Projet-Esme-2022-3B6/Chirurginoux/Liens utiles/Liens utiles.docx

# Liens utiles

Compréhension axes / coordonnées Kinect :

https://lisajamhoury.medium.com/understanding-kinect-v2-joints-and-coordinate-system-4f4b90b9df16
