Projet-Esme-2022-3B6/Chirurginoux/Docs/Modele-Geometrique (1).docx

Z3

X3

Y3

d_4 =375

α_2 =253

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
Axe | θ | d | a | α
1 | θ_1 | d_1 =145 | 0 | -π/2
2 | θ_2 | 0 | a_2 =253 | 0
3 | θ_3 =θ^(') _3 -π/2 | 0 | a_3 =375 | 0
4 | θ_4 | d_4 =375 | 0 | -π/2

d_1 =145

Y0

Z0

X0

T_0^1 =C_1 , 0, -S_1 , 0S_1 , 0, C_1 , 00, -1, 0, d_1 0, 0, 0, 1 T_1^2 =C_2 , -S_2 , 0, a_2 C_2 S_2 , C_2 , 0, a_2 S_2 0, 0, 1, 00, 0, 0, 1

T_0^2 =C_1 C_2 , -C_1 S_2 , -S_1 , a_2 C_1 C_2 S_1 C_2 , -S_1 S_2 , C_1 , a_2 S_1 C_2 -S_2 , -C_2 , 0, d_1 -a_2 S_2 0, 0, 0, 1 T_2^3 =C_3 , -S_3 , 0, a_3 C_3 S_3 , C_3 , 0, a_3 S_3 0, 0, 1, 00, 0, 0, 1

T_0^3 =C_1 C_2 C_3 -C_1 S_2 S_3 , -C_1 C_2 S_3 -C_1 S_2 C_3 , -S_1 , C_1 C_2 a_3 C_3 -C_1 S_2 a_3 S_3 +a_2 C_1 C_2 S_1 C_2 C_3 -S_1 S_2 S_3 , -S_1 C_2 S_3 -S_1 S_2 C_3 , C_1 , S_1 C_2 a_3 C_3 -S_1 S_2 a_3 S_3 +a_2 S_1 C_2 -S_2 C_3 -C_2 S_3 , S_2 S_3 -C_2 C_3 , 0, d_1 -a_2 S_2 0, 0, 0, 1

T_0^3 =C_1 C_23 , -C_1 S_23 , -S_1 , C_1 (a_3 C_23 +a_2 C_2 )S_1 C_23 , -S_1 S_23 , C_1 , S_1 (a_3 C_23 +a_2 C_2 )-S_23 , -C_23 , 0, d_1 -a_2 S_2 0, 0, 0, 1 T_3^4 =1, 0, 0, 00, 0, 1, 00, -1, 0, 00, 0, 0, 1

T_0^4 =C_1 C_23 , S_1 , -C_1 S_23 , C_1 (a_3 C_23 +a_2 C_2 )S_1 C_23 , -C_1 , -S_1 S_23 , S_1 (a_3 C_23 +a_2 C_2 )-S_23 , 0, -C_23 , d_1 -a_2 S_2 0, 0, 0, 1
T_4^5 =C_5 , -S_5 , 0, 0S_5 , C_5 , 0, 00, 0, 1, 00, 0, 0, 1

T_0^5 =C_4 C_1 C_23 +S_4 S_1 , -S_4 C_1 C_23 +C_4 S_1 , -C_1 S_23 , C_1 (a_3 C_23 +a_2 C_2 )C_4 S_1 C_23 -S_4 C_1 , -S_4 S_1 C_23 -C_4 C_1 , -S_1 S_23 , S_1 (a_3 C_23 +a_2 C_2 )-C_4 S_23 , S_4 S_23 , -C_23 , d_1 -a_2 S_2 0, 0, 0, 1

w(q)=[C_1 (a_2 C_2 -d_4 S_23 )S_1 (a_2 C_2 -d_4 S_23 )d_1 -a_2 S_2 -d_4 C_23 ⋯⋯⋯⋯⋯⋯⋯⋯-e^((q_4)/π) C_1 S_23 -e^((q_4)/π) S_1 S_23 -e^((q_4)/π) C_23 ]

(w_2)/(w_1)=(S_1 (a_2 C_2 -d_4 S_23 ))/(C_1 (a_2 C_2 -d_4 S_23 ))=(S_1)/(C_1)→q_1 =atan2(w_2 ,w_1 )

C_1 w_4 +S_1 w_5 =-e^((q_4)/π) C_1^2 S_23 -e^((q_4)/π) S_1^2 S_23 =-e^((q_4)/π) S_23 (C_1^2 +S_1^2 )=-e^((q_4)/π) S_23

(C_1 w_4 +S_1 w_5)/(w_6)=(-e^((q_4)/π) S_23)/(-e^((q_4)/π) C_23)=(S_23)/(C_23)→q_23 =atan2((C_1 w_4 +S_1 w_5 ) , w_6 )

C_1 w_1 +S_1 w_2 =C_1^2 (a_2 C_2 -d_4 S_23 )+S_1^2 (a_2 C_2 -d_4 S_23 )=a_2 C_2 -d_4 S_23

→C_2 =(C_1 w_1 +S_1 w_2 +d_4 S_23)/(a_2)

d_1 -w_3 =a_2 S_2 +d_4 C_23 (d_1 -w_3 -d_4 C_23)/(C_1 w_1 +S_1 w_2 +d_4 S_23)=(S_2)/(C_2)

→S_2 =(d_1 -w_3 -d_4 C_23)/(a_2) →q_2 =atan2(d_1 -w_3 -d_4 C_23 , C_1 w_1 +S_1 w_2 +d_4 S_23 )

w_4^2 +w_5^2 +w_6^2 =(-e^((q_4)/π) C_1 S_23 )^2 +(-e^((q_4)/π) S_1 S_23 )^2 +(-e^((q_4)/π) C_23 )^2 =(e^((q_4)/π) )^2 (S_23 ^2 (C_1 ^2 +S_1 ^2 )+C_23 ^2 )

q_4 =π ln(√(w_4^2 +w_5^2 +w_6^2))

q_1 =atan2(w_2 ,w_1 )

q_23 =atan2((C_1 w_4 +S_1 w_5 ) , w_6 )

q_2 =atan2(d_1 -w_3 -d_4 C_23 , C_1 w_1 +S_1 w_2 +d_4 S_23 )

q_3 =q_23 -q_2

q_4 =π ln(√(w_4^2 +w_5^2 +w_6^2))
