Projet-Esme-2022-3B6/Chirurginoux/Docs/Modèle géométrique.docx

X3

Y3

Z3

Z4

X4

d_5 =375

a_3 =253

X5

Z2

X2

Y2

Y5

Z5

Y4

d_2 =145

Axe | θ | d | a | α | Home
1 | θ_1 | 0 | 0 | 0 | 0
2 | θ_2 | d_2 =145 | 0 | -π/2 | 0
3 | θ_3 | 0 | a_3 =253 | 0 | 0
4 | θ_4 =θ^(') _4 -π/2 | 0 | 0 | -π/2 | -π/2
5 | 0 | d_5 =375 | 0 | 0

Z0 = Z1

Y0

X0

T_(K-1)^K =[Cθ_k , -Cα_k Sθ_k , Sα_k Sθ_k , ⋮, a_k Cθ_k Sθ_k , Cα_k Cθ_k , -Sα_k Cθ_k , ⋮, a_k Sθ_k 0, Sα_k , Cα_k , ⋮, d_k ⋯, ⋯, ⋯, ⋮, ⋯0, 0, 0, ⋮, 1]

T_1^2 =C_2 , 0, -S_2 , 0S_2 , 0, C_2 , 00, -1, 0, d_2 0, 0, 0, 1

T_0^1 =C_1 , -S_1 , 0, 0S_1 , C_1 , 0, 00, 0, 1, 00, 0, 0, 1 T_0^2 =C_1 C_2 -S_1 S_2 , 0, -C_1 S_2 -S_1 C_2 , 0S_1 C_2 +C_1 S_2 , 0, -S_1 S_2 +C_1 C_2 , 00, -1, 0, d_2 0, 0, 0, 1

T_2^3 =C_3 , -S_3 , 0, a_3 C_3 S_3 , C_3 , 0, a_3 S_3 0, 0, 1, 00, 0, 0, 1

T_0^2 =C_(1,2) , 0, -S_(1,2) , 0S_(1,2) , 0, C_(1,2) , 00, -1, 0, d_2 0, 0, 0, 1 T_0^3 =C_(1,2) C_3 , -C_(1,2) S_3 , -S_(1,2) , C_(1,2) a_3 C_3 S_(1,2) C_3 , -S_(1,2) S_3 , C_(1,2) , S_(1,2) a_3 C_3 -S_3 , -C_3 , 0, -a_3 S_3 +d_2 0, 0, 0, 1

T_3^4 =C_4 , 0, -S_4 , 0S_4 , 0, C_4 , 00, -1, 0, 00, 0, 0, 1

T_0^3 =C_(1,2) C_3 , -C_(1,2) S_3 , -S_(1,2) , C_(1,2) a_3 C_3 S_(1,2) C_3 , -S_(1,2) S_3 , C_(1,2) , S_(1,2) a_3 C_3 -S_3 , -C_3 , 0, -a_3 S_3 +d_2 0, 0, 0, 1

T_0^4 =C_(1,2) (C_3 C_4 -S_3 S_4 ), S_(1,2) , -C_(1,2) (C_3 S_4 +S_3 C_4 ), C_(1,2) a_3 C_3 S_(1,2) (C_3 C_4 -S_3 S_4 ), -C_(1,2) , -S_(1,2) (C_3 S_4 +S_3 C_4 ), S_(1,2) a_3 C_3 -S_3 C_4 -C_3 S_4 , 0, S_3 S_4 -C_3 C_4 , -a_3 S_3 +d_2 0, 0, 0, 1

T_4^5 =1, 0, 0, 00, 1, 0, 00, 0, 1, d_5 0, 0, 0, 1

T_0^4 =C_(1,2) C_(3,4) , S_(1,2) , -C_(1,2) S_(3,4) , a_3 C_(1,2) C_3 S_(1,2) C_(3,4) , -C_(1,2) , -S_(1,2) S_(3,4) , a_3 S_(1,2) C_3 -S_(3,4) , 0, -C_(3,4) , -a_3 S_3 +d_2 0, 0, 0, 1

T_0^5 =C_(1,2) C_(3,4) , S_(1,2) , -C_(1,2) S_(3,4) , C_(1,2) (a_3 C_3 -S_(3,4) d_5 )S_(1,2) C_(3,4) , -C_(1,2) , -S_(1,2) S_(3,4) , S_(1,2) (a_3 C_3 -S_(3,4) d_5 )-S_(3,4) , 0, -C_(3,4) , d_2 -a_3 S_3 -C_(3,4) d_5 0, 0, 0, 1

w(q)=[C_(1,2) (a_3 C_3 -S_(3,4) d_5 )S_(1,2) (a_3 C_3 -S_(3,4) d_5 )d_2 -a_3 S_3 -C_(3,4) d_5 ⋯⋯⋯⋯⋯⋯⋯⋯-e^((q_4)/π) C_(1,2) S_(3,4) -e^((q_4)/π) S_(1,2) S_(3,4) -e^((q_4)/π) C_(3,4) ]

(w_2)/(w_1)=(S_(1,2) (a_3 C_3 -S_(3,4) d_5 ))/(C_(1,2) (a_3 C_3 -S_(3,4) d_5 ))=(S_(1,2))/(C_(1,2))→q_(1,2) =atan2(w_2 ,w_1 )

C_(1,2) w_4 +S_(1,2) w_5 =-e^((q_4)/π) C_(1,2)^2 S_(3,4) -e^((q_4)/π) S_(1,2)^2 S_(3,4) =-e^((q_4)/π) S_(3,4) (C_(1,2)^2 +S_(1,2)^2 )=-e^((q_4)/π) S_(3,4)

(C_(1,2) w_4 +S_(1,2) w_5)/(w_6)=(-e^((q_4)/π) S_(3,4))/(-e^((q_4)/π) C_(3,4))=(S_(3,4))/(C_(3,4))→q_(3,4) =atan2((C_(1,2) w_4 +S_(1,2) w_5 ) , w_6 )

√(w_4^2 +w_5^2 +w_6^2)=e^((q_4)/π) √((S_(3,4) ^2 (C_(1,2) ^2 +S_(1,2) ^2 )+C_(3,4) ^2 ))=e^((q_4)/π)

q_4 =π ln(√(w_4^2 +w_5^2 +w_6^2))

q_(1,2) =atan2(w_2 ,w_1 )

q_(3,4) =atan2((C_(1,2) w_4 +S_(1,2) w_5 ) , w_6 )

q_4 =π ln(√(w_4^2 +w_5^2 +w_6^2))

q_3 =q_(3,4) -q_4
