Projet-Esme-2022-3B6/Chirurginoux/Docs/Commande Projet Groupe 6 .xlsx

Composants |  | Liens | Nombres | Prix | Description
Moteurs 35KG |  | https://www.amazon.fr/FEICHAO-num%C3%A9rique-%C3%A9tanche-Aluminium-Engrenages/dp/B08CSCLGHV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 | 2 | 59.96 | Moteurs pour les 2 bras
Convertisseurs DC/DC |  | https://www.amazon.fr/6paquets-Converter-3-0-40V-1-5-35V-Convertisseur/dp/B07793ZH9K?hvadid=313717846711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 | 1 paquet | 10.69 | Dispo à l'ecole
Cables Males / femelles |  | https://www.amazon.fr/Elegoo-Breadboard-Femelle-Longueur-Arduino/dp/B01JD5WCG2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 | 1 paquet | 9.99 | Dispo à l'ecole
Roulement à billes |  | https://www.amazon.fr/roulements-multi-usages-caoutchouc-profonde-6001-2RS/dp/B07N82SK41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 | 1 paquet | 19.69 | Dispo à l'ecole
Moteurs MG996R |  | https://www.amazon.fr/Diymore-Digital-H%C3%A9licopt%C3%A8re-Voiture-commandes/dp/B07KD6NVPM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 | 2 | 17.99 | Dispo à l'ecole / Moteurs pour base et pince
Câbles Ralonge Moteur |  | https://www.amazon.fr/GTIWUNG-Extension-Dextension-Servomoteur-Recepteur/dp/B082WYFWSY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 | 1 paquet | 12.99 | Cable de rallonge esthetique
scalpel |  | https://www.amazon.fr/Westcott-84010-00-Scalpel-poign%C3%A9e-interchangeable-argent/dp/B002QRKARS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 | 1 | 4.42
adaptateur ethernet / usb |  | https://www.amazon.fr/Mobi-Lock-Adaptateur-P%C3%A9riph%C3%A9riques-Compatibles/dp/B00NLL10P4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 | 1 | 9.99
Plaque wrapping |  | https://www.amazon.fr/Prototype-Circuit-Universel-Prototypage-Bbricolage/dp/B08YXKRJY1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 | 1 paquet | 8.99 | Dispo à l'ecole
Transformateur 220V 12V |  | https://www.amazon.fr/Transformateur-Adaptateur-Bande-Alimentation-V-220/dp/B01G0Q3RWU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 | 1 | 8.42
Microsoft Kinect V2 |  |  |  | 80 | Deja Reçu
Raspberry Pi 3B+ |  |  |  | 61 | Deja Reçu
Prix Total | 304.13 | / 150
