Projet-Esme-2022-3B6/Chirurginoux/3D/3D 2.0/Motor/Servo MG996R/MG996R.SLDASM

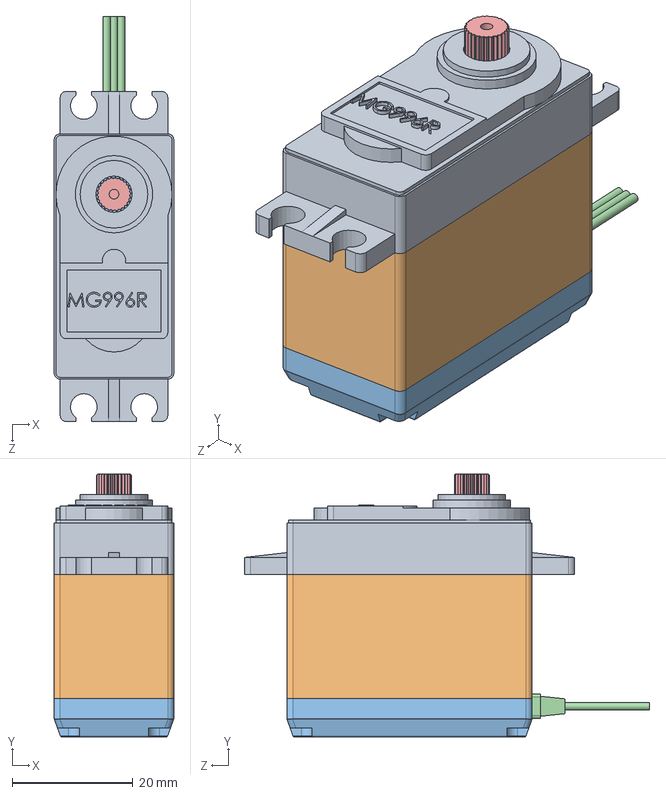
[picture p15: CAD file, 2022-01-17]
3D/3D 2.0/Motor/Servo MG996R/MG996R.SLDASM
19.8 x 43.5 x 67.0 mm
Top MG996R
Middle MG996R
Bottom MG996R
Connector MG996R
Shaft MG996R
