Projet-Esme-2022-3B6/Chirurginoux/3D/3D/Motor/Servo 35KG/Servo 35kg.SLDASM

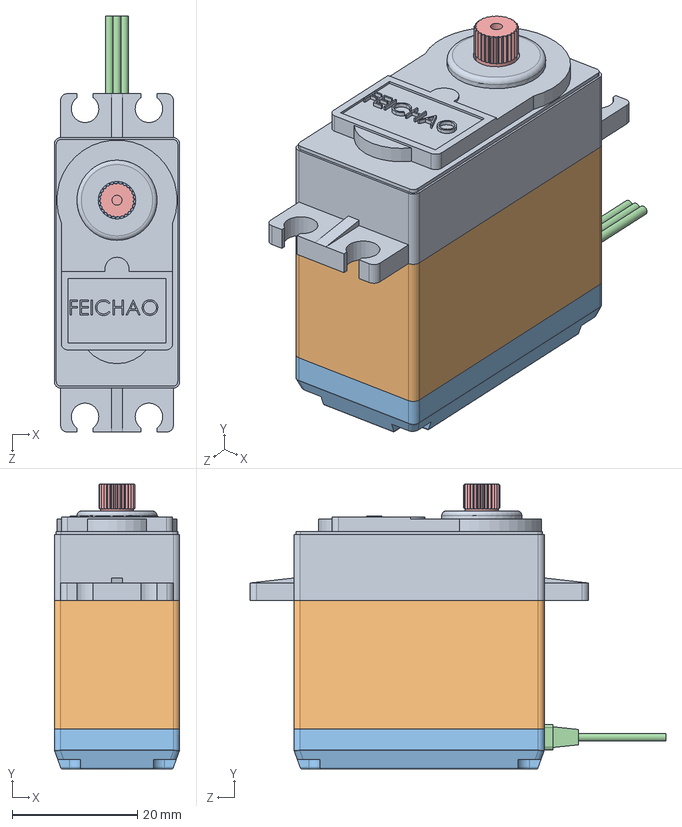
[picture p16: CAD file, 2022-01-17]
3D/3D/Motor/Servo 35KG/Servo 35kg.SLDASM
20.0 x 45.5 x 66.4 mm
BODY, TOP
BODY, MIDDLE
BOTTOM
CONNECTOR
SHAFT
