Projet-Esme-2022-3B6/Chirurginoux/3D/Ancienne Version/3D V3/Roulement à billes/Assemblage Roulement.SLDASM

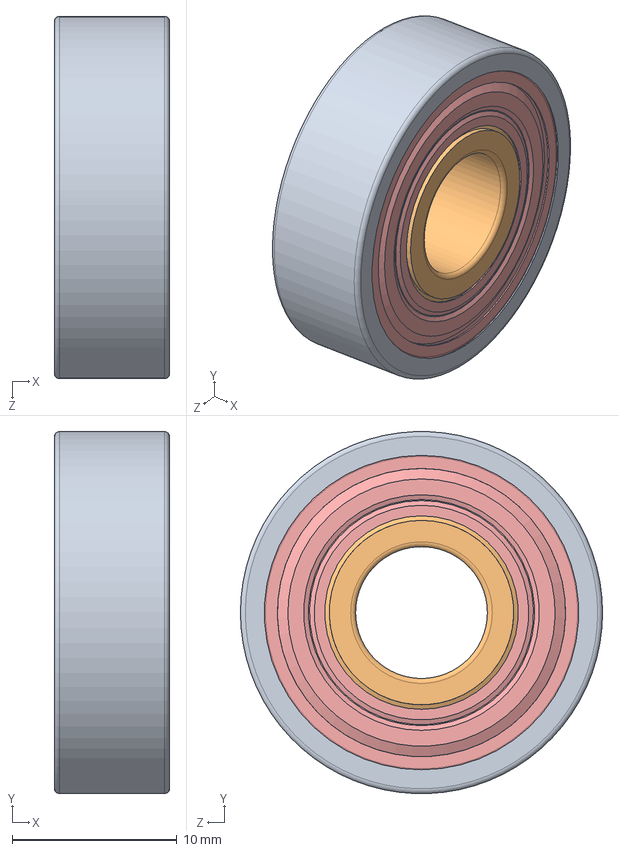
[picture p17: CAD file, 2022-01-17]
3D/Ancienne Version/3D V3/Roulement à billes/Assemblage Roulement.SLDASM
7.00 x 22.0 x 22.0 mm
Roulement 1
Roulement 2
Roulement 3
Roulement 4
Roulement 5
