Projet-Esme-2022-3B6/Chirurginoux/3D/3D 2.0/Assemblage Kinect Arm 2.0.SLDASM

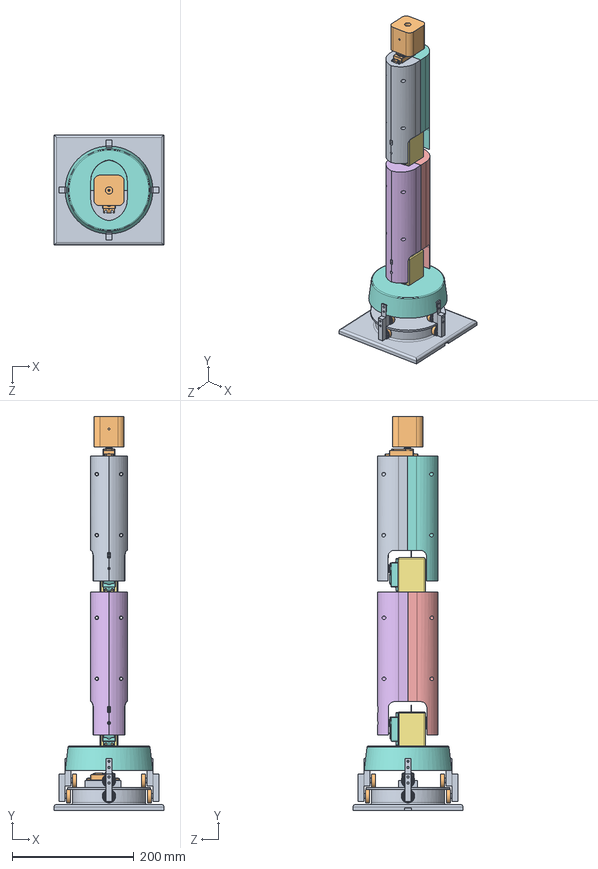
[picture p18: CAD file, 2022-03-29]
3D/3D 2.0/Assemblage Kinect Arm 2.0.SLDASM
180.0 x 646.0 x 180.0 mm
base
Top MG996R x 2
Middle MG996R x 2
Bottom MG996R x 2
Connector MG996R x 2
Shaft MG996R x 2
Servo Control Horns MG996R
tronc
Pate Tronc x 8
Roulement 1 x 10
Roulement 2 x 10
Roulement 3 x 10
Roulement 4 x 10
Roulement 5 x 10
Support Moteur 2.0 x 2
BODY, TOP x 2
BODY, MIDDLE x 2
BOTTOM x 2
CONNECTOR x 2
SHAFT x 2
Bras séparé Roulement
Bras séparé Motor
25T Horns x 2
Avant Bras séparé Roulement
Avant Bras séparé Motor
Pièce_support_scalpel
