Projet-Esme-2022-3B6/Chirurginoux/3D/3D 2.0/Scalpel/Scalpel FEATHER #3.SLDASM

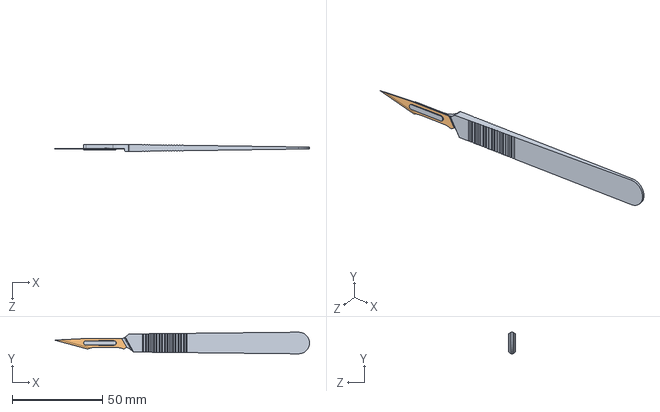
[picture p20: CAD file, 2022-03-29]
3D/3D 2.0/Scalpel/Scalpel FEATHER #3.SLDASM
141.1 x 12.0 x 4.00 mm
Scalpel FEATHER #3 - Manche
Scalpel FEATHER #3 - Lame
