Projet-Esme-2022-3B6/Chirurginoux/3D/Ancienne Version/3D V3/Assemblage Base-Tronc.SLDASM

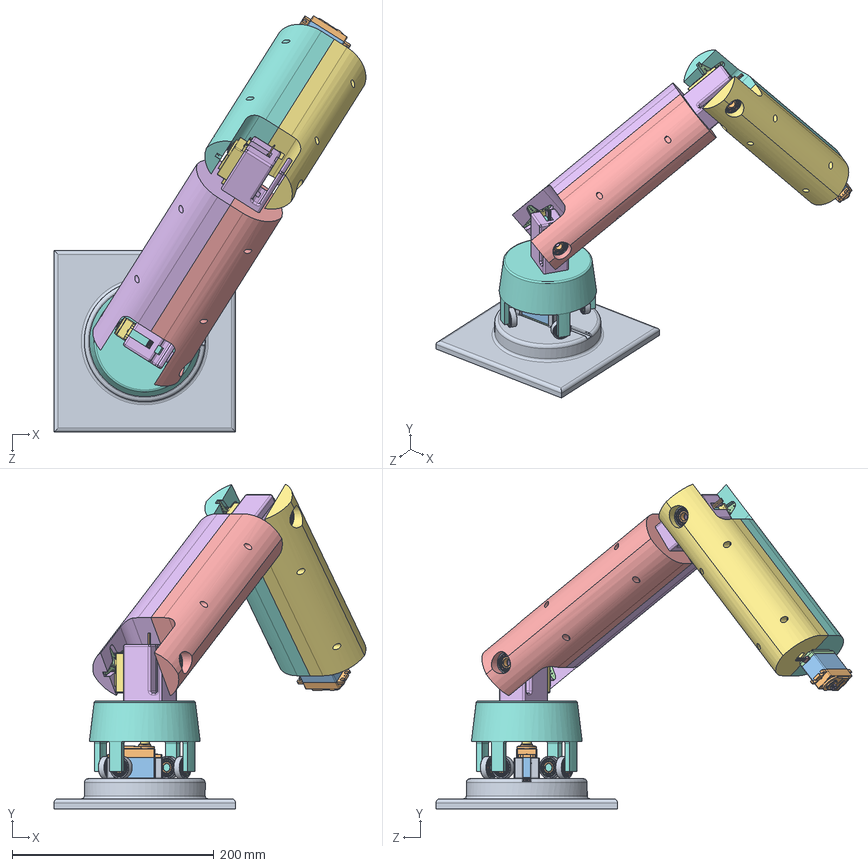
[picture p21: CAD file, 2022-01-17]
3D/Ancienne Version/3D V3/Assemblage Base-Tronc.SLDASM
309.3 x 322.0 x 412.5 mm
base
Top MG996R x 2
Middle MG996R x 2
Bottom MG996R x 2
Connector MG996R x 2
Shaft MG996R x 2
Servo Control Horns MG996R
tronc
Roulement 1 x 6
Roulement 2 x 6
Roulement 3 x 6
Roulement 4 x 6
Roulement 5 x 6
Support Moteur 2.0 x 2
BODY, TOP x 2
BODY, MIDDLE x 2
BOTTOM x 2
CONNECTOR x 2
SHAFT x 2
Servo Control Horns x 2
Bras séparé en deux1
Bras séparé en deux2
Avant Bras séparé en deux1
Avant Bras séparé en deux2
