Projet-Esme-2022-3B6/Chirurginoux/3D/3D 2.0/Bras/Bras séparé Motor.SLDPRT

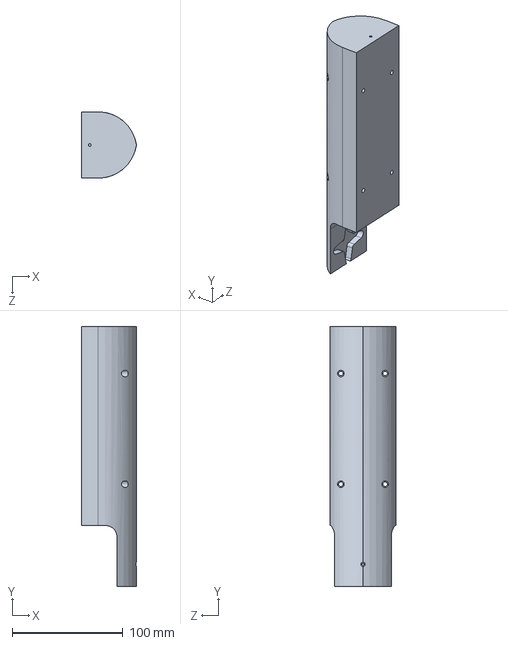
[picture p23: CAD file, 2022-01-20]
3D/3D 2.0/Bras/Bras séparé Motor.SLDPRT
49.6 x 235.0 x 60.0 mm
