Projet-Esme-2022-3B6/Chirurginoux/3D/3D 2.0/Motor/Servo 35KG/25T Horns.SLDPRT

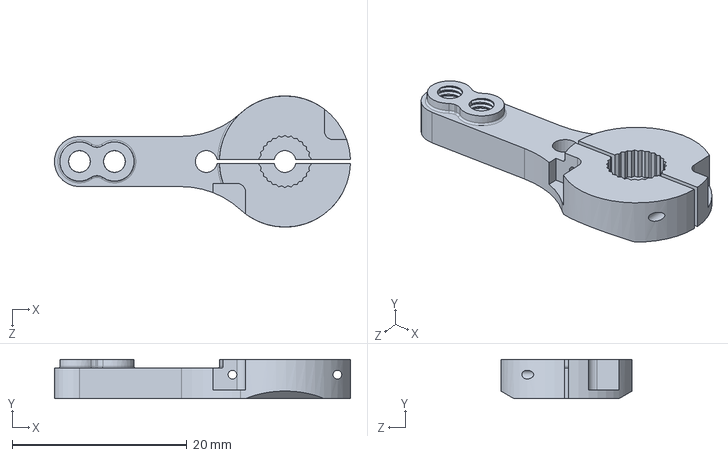
[picture p24: CAD file, 2022-01-20]
3D/3D 2.0/Motor/Servo 35KG/25T Horns.SLDPRT
33.8 x 4.50 x 15.0 mm
