Projet-Esme-2022-3B6/Chirurginoux/3D/3D 2.0/Pièce_support_scalpel.SLDPRT

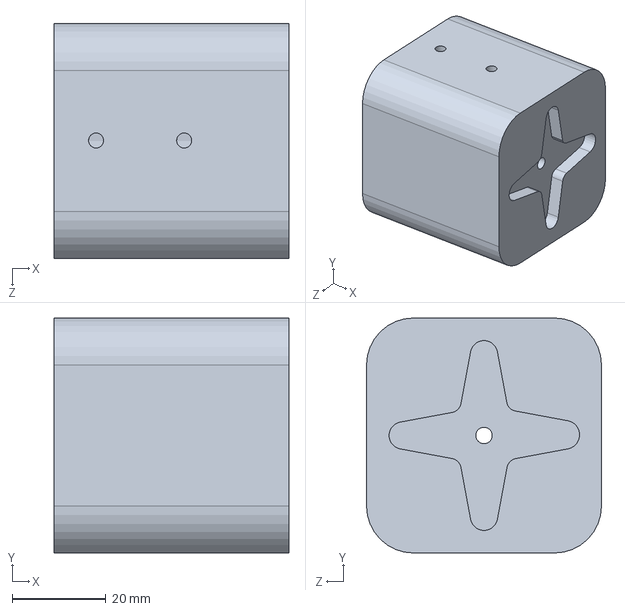
[picture p25: CAD file, 2022-03-29]
3D/3D 2.0/Pièce_support_scalpel.SLDPRT
50.0 x 50.0 x 50.0 mm
