Projet-Esme-2022-3B6/Chirurginoux/3D/3D 2.0/Scalpel/Scalpel FEATHER #3 - Lame.SLDPRT

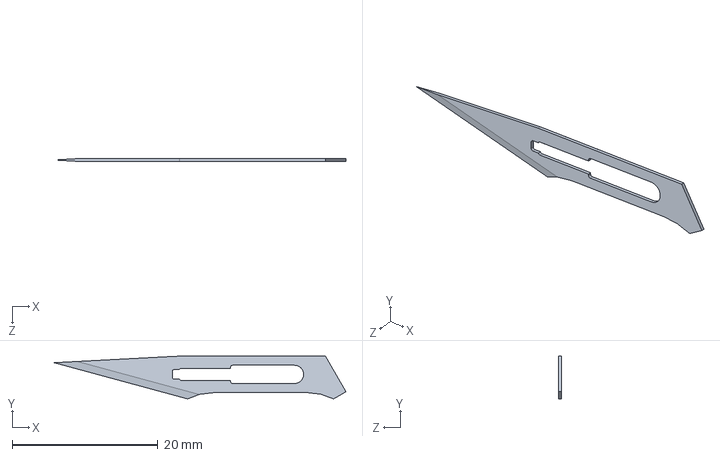
[picture p26: CAD file, 2022-03-29]
3D/3D 2.0/Scalpel/Scalpel FEATHER #3 - Lame.SLDPRT
40.0 x 5.86 x 0.38 mm
