Projet-Esme-2022-3B6/Chirurginoux/3D/3D/Bras/Bras séparé en deux1 .SLDPRT

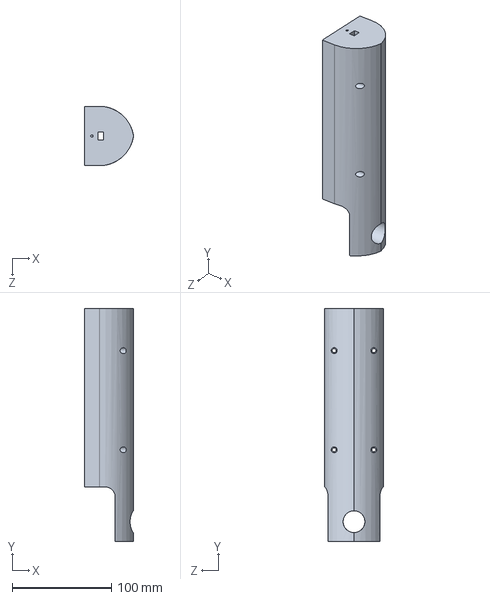
[picture p27: CAD file, 2022-01-17]
3D/3D/Bras/Bras séparé en deux1 .SLDPRT
49.6 x 235.0 x 60.0 mm
