Projet-Esme-2022-3B6/Chirurginoux/3D/3D/Motor/Servo MG996R/Connector MG996R.SLDPRT

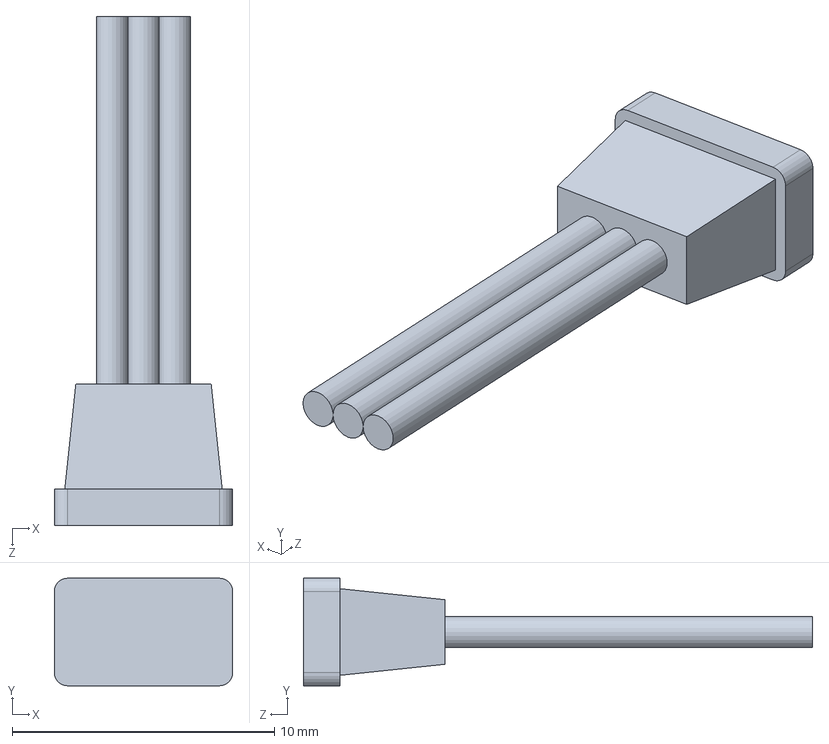
[picture p28: CAD file, 2022-01-17]
3D/3D/Motor/Servo MG996R/Connector MG996R.SLDPRT
6.80 x 4.10 x 19.4 mm
