Projet-Esme-2022-3B6/Chirurginoux/3D/3D/Support Moteur 2.0.SLDPRT

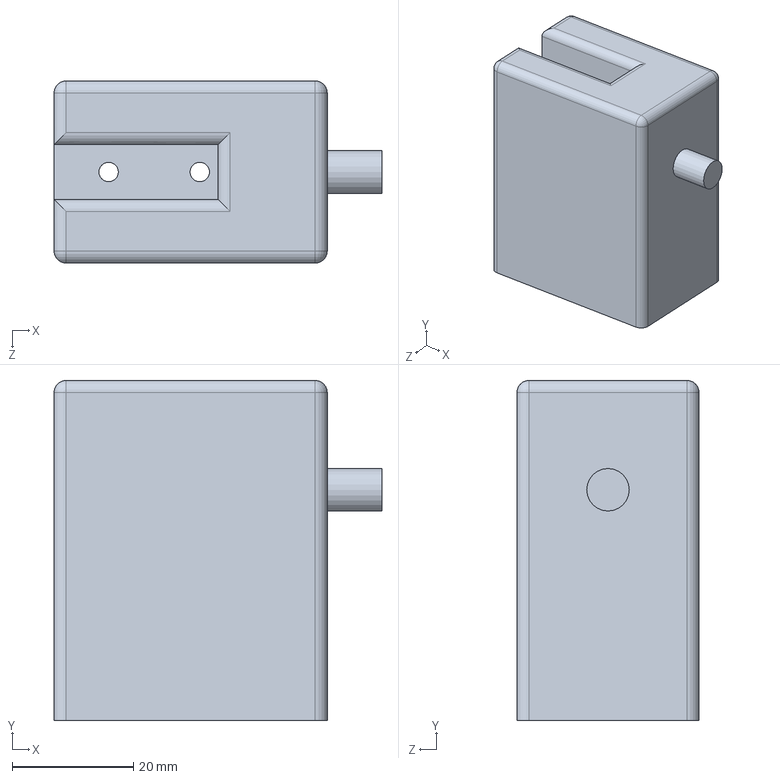
[picture p29: CAD file, 2022-01-17]
3D/3D/Support Moteur 2.0.SLDPRT
54.0 x 56.0 x 30.0 mm
