Projet-Esme-2022-3B6/Chirurginoux/3D/Ancienne Version/3D V3/Motor/Servo 35KG/HORN.SLDPRT

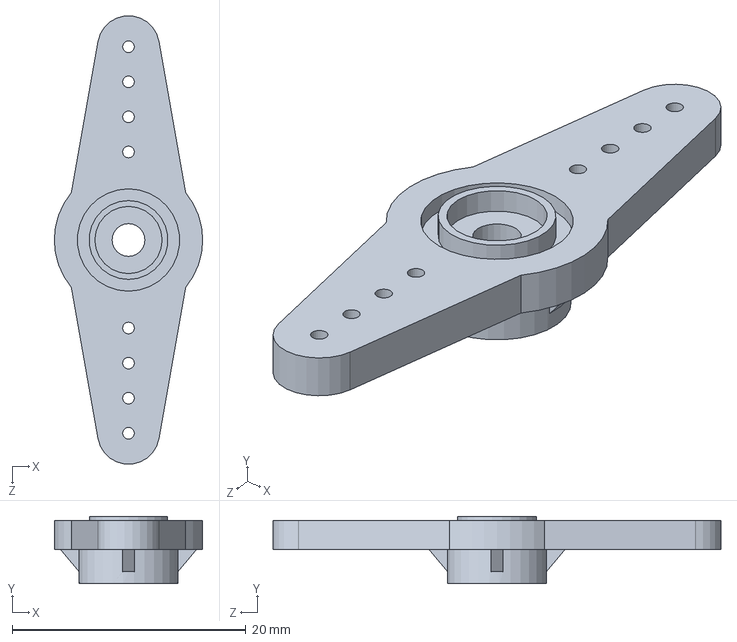
[picture p30: CAD file, 2022-01-17]
3D/Ancienne Version/3D V3/Motor/Servo 35KG/HORN.SLDPRT
12.7 x 5.75 x 38.3 mm
