Projet-Esme-2022-3B6/Chirurginoux/3D/Ancienne Version/3D V3/tronc.SLDPRT

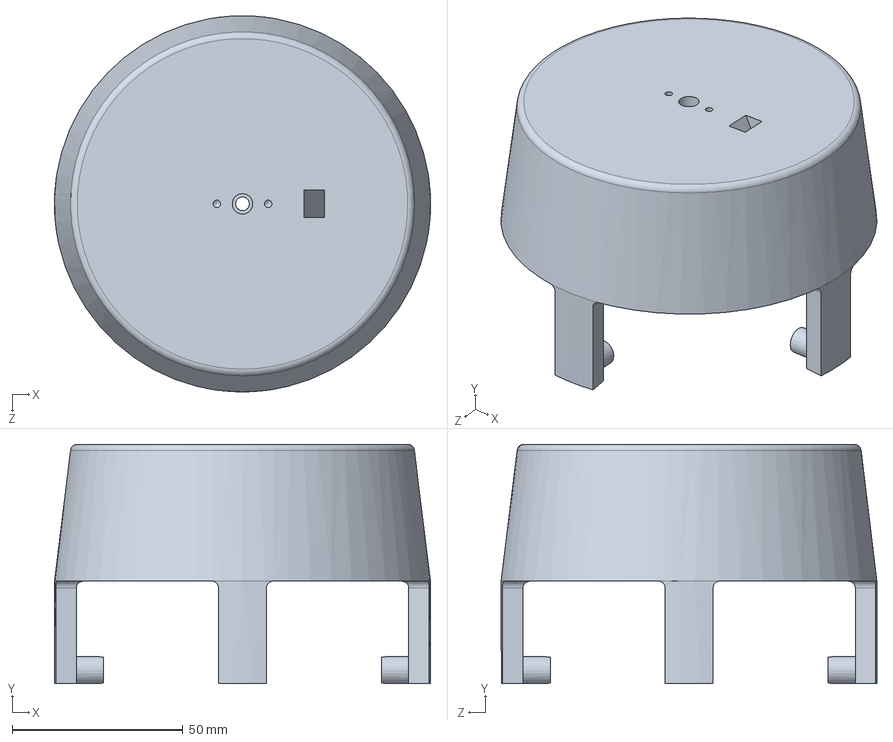
[picture p31: CAD file, 2022-01-17]
3D/Ancienne Version/3D V3/tronc.SLDPRT
109.9 x 70.0 x 109.9 mm
