Projet-Esme-2022-3B6/Chirurginoux/3D/STL 2.0/Pate Tronc.STL

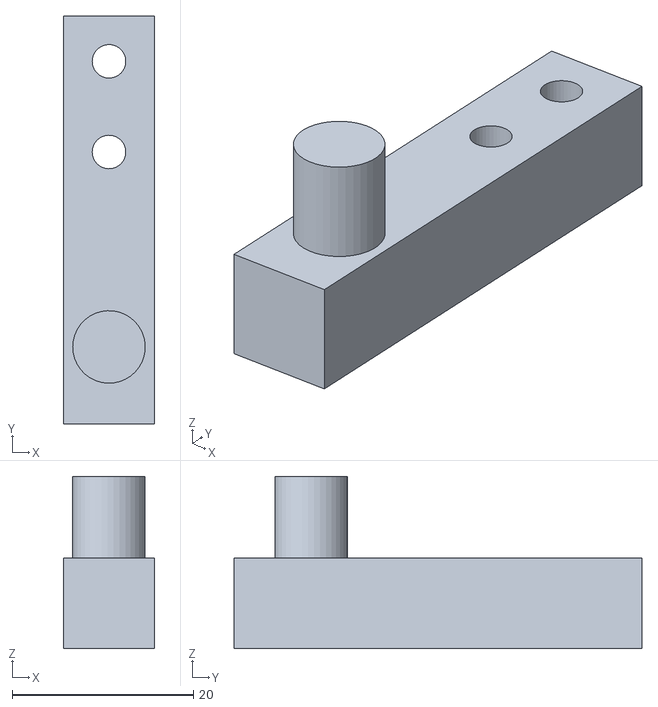
[picture p32: CAD file, 2022-01-20]
3D/STL 2.0/Pate Tronc.STL
10.0 x 45.0 x 19.0
