Projet-Esme-2022-3B6/Chirurginoux/3D/3D 2.0/Avant bras/Avant Bras séparé Roulement.SLDPRT

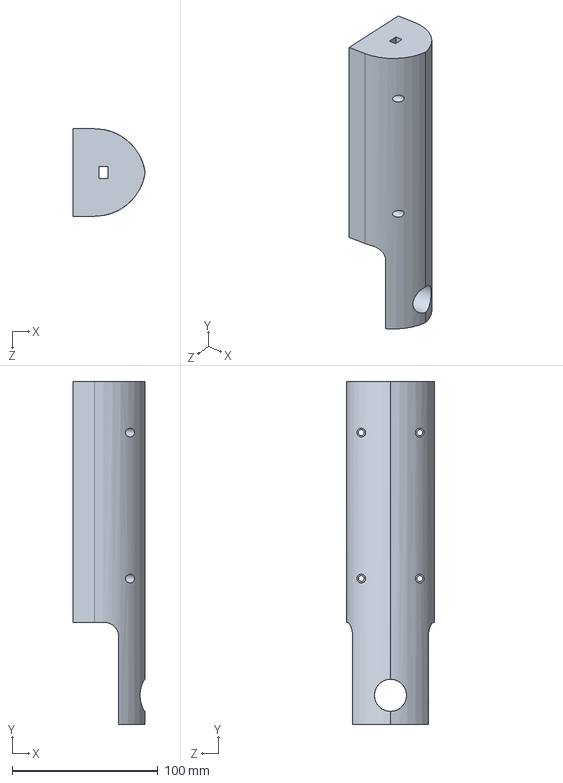
[picture p33: CAD file, 2022-03-29]
3D/3D 2.0/Avant bras/Avant Bras séparé Roulement.SLDPRT
49.6 x 235.0 x 60.0 mm
