Projet-Esme-2022-3B6/Chirurginoux/3D/3D 2.0/Motor/Servo 35KG/BOTTOM.SLDPRT

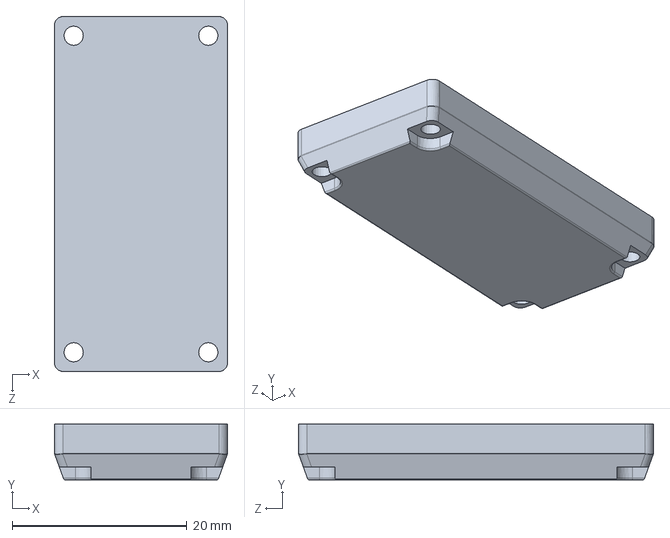
[picture p34: CAD file, 2022-01-17]
3D/3D 2.0/Motor/Servo 35KG/BOTTOM.SLDPRT
19.8 x 6.40 x 40.6 mm
