Projet-Esme-2022-3B6/Chirurginoux/3D/3D 2.0/Scalpel/Scalpel FEATHER #3 - Manche.SLDPRT

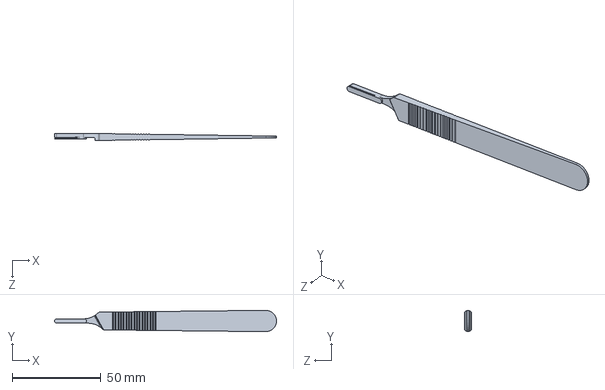
[picture p35: CAD file, 2022-03-29]
3D/3D 2.0/Scalpel/Scalpel FEATHER #3 - Manche.SLDPRT
125.0 x 12.0 x 4.00 mm
