Projet-Esme-2022-3B6/Chirurginoux/3D/3D 2.0/Tronc/tronc.SLDPRT

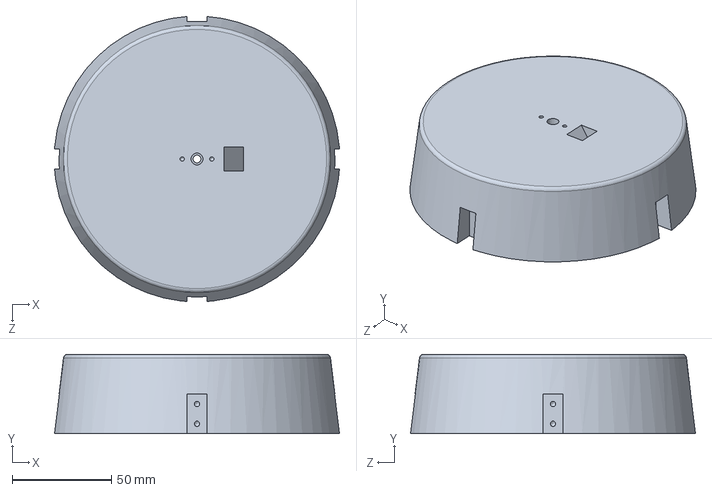
[picture p36: CAD file, 2022-02-10]
3D/3D 2.0/Tronc/tronc.SLDPRT
143.7 x 40.0 x 143.7 mm
