Projet-Esme-2022-3B6/Chirurginoux/3D/3D/Motor/Servo 35KG/SHAFT.SLDPRT

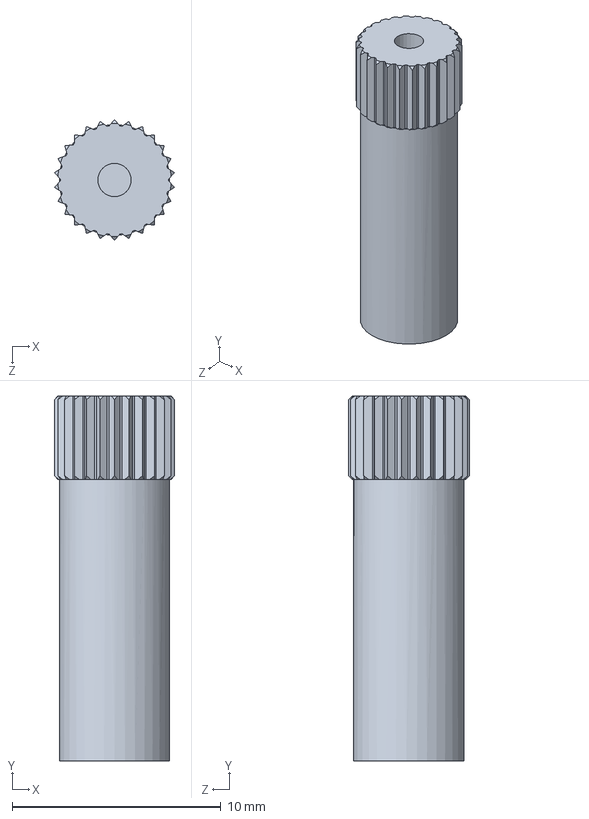
[picture p37: CAD file, 2022-01-17]
3D/3D/Motor/Servo 35KG/SHAFT.SLDPRT
5.76 x 17.5 x 5.80 mm
