Projet-Esme-2022-3B6/Chirurginoux/3D/Ancienne Version/3D V3/Motor/Servo 35KG/BODY, MIDDLE.SLDPRT

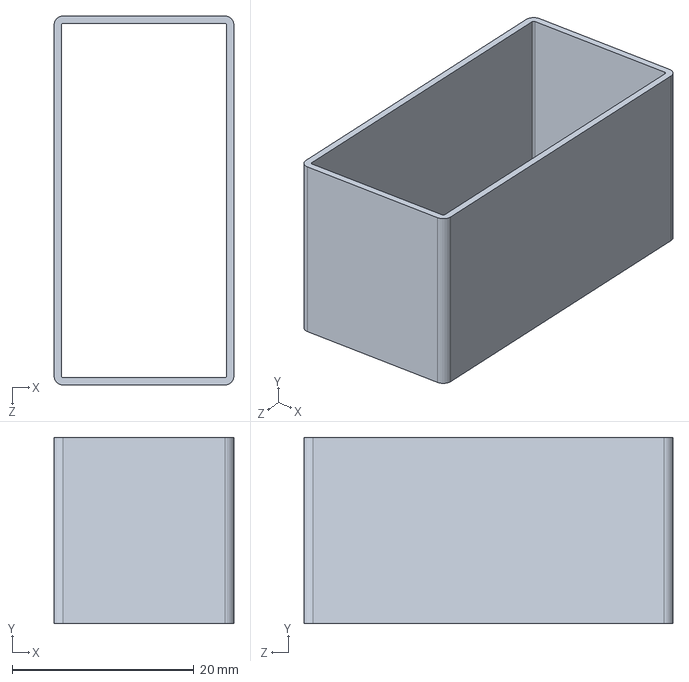
[picture p38: CAD file, 2022-01-17]
3D/Ancienne Version/3D V3/Motor/Servo 35KG/BODY, MIDDLE.SLDPRT
19.8 x 20.5 x 40.6 mm
