Projet-Esme-2022-3B6/Chirurginoux/3D/Ancienne Version/3D V3/Pièce_support_scalpel.SLDPRT

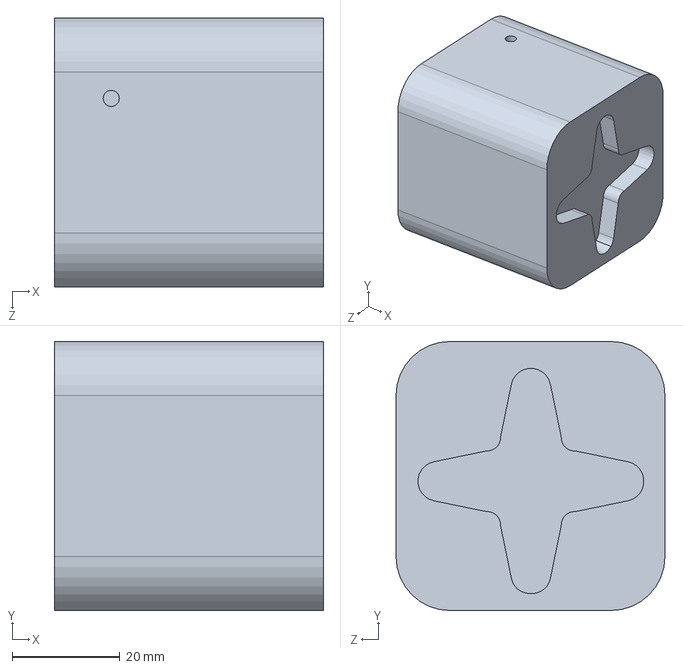
[picture p39: CAD file, 2022-01-17]
3D/Ancienne Version/3D V3/Pièce_support_scalpel.SLDPRT
50.0 x 50.0 x 50.0 mm
