Projet-Esme-2022-3B6/Chirurginoux/3D/3D 2.0/Motor/Servo 35KG/BODY, TOP.SLDPRT

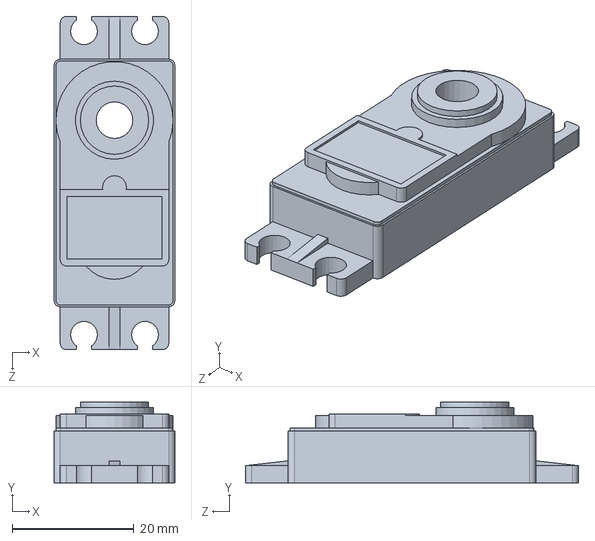
[picture p41: CAD file, 2022-01-17]
3D/3D 2.0/Motor/Servo 35KG/BODY, TOP.SLDPRT
19.8 x 13.2 x 54.6 mm
