Projet-Esme-2022-3B6/Chirurginoux/3D/Ancienne Version/3D V3/base.SLDPRT

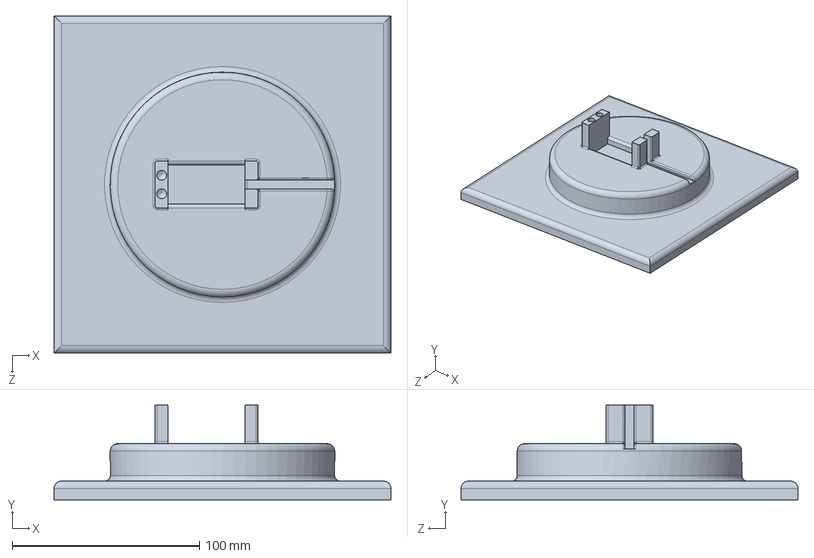
[picture p42: CAD file, 2022-01-17]
3D/Ancienne Version/3D V3/base.SLDPRT
180.0 x 50.5 x 180.0 mm
