Projet-Esme-2022-3B6/Chirurginoux/3D/Ancienne Version/3D V3/Motor/Servo 35KG/Servo Control Horns.SLDPRT

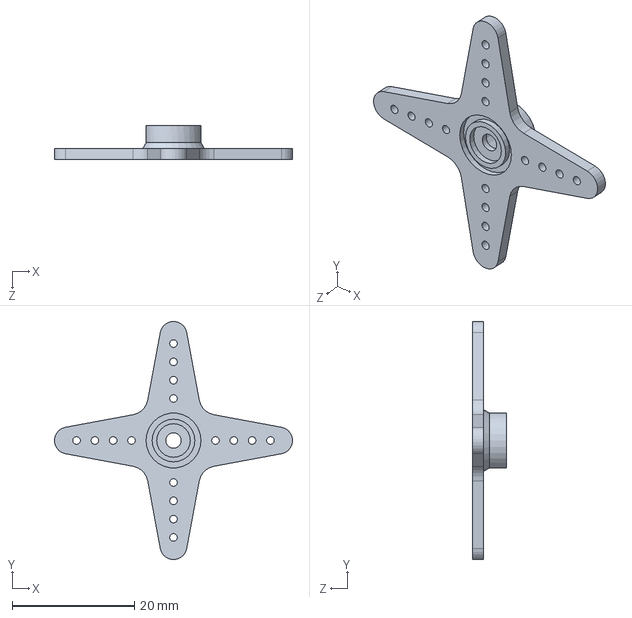
[picture p43: CAD file, 2022-01-17]
3D/Ancienne Version/3D V3/Motor/Servo 35KG/Servo Control Horns.SLDPRT
39.0 x 39.0 x 5.50 mm
