Projet-Esme-2022-3B6/Chirurginoux/3D/Fichier STL/CCR10SPRO_tronc.3mf

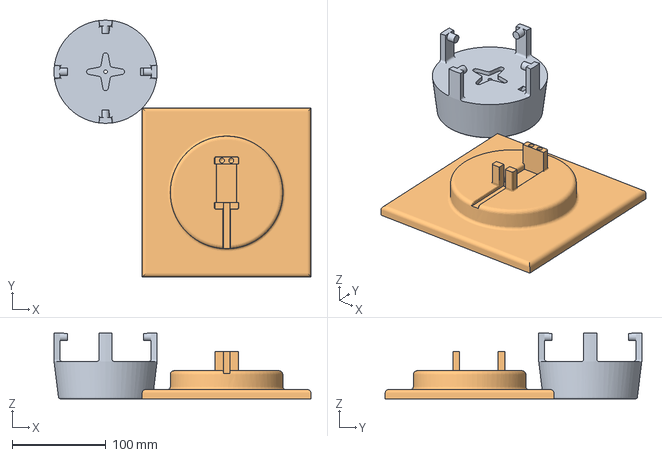
[picture p44: CAD file, 2022-01-17]
3D/Fichier STL/CCR10SPRO_tronc.3mf
274.0 x 273.7 x 70.0 mm
tronc.STL
base.STL
