Projet-Esme-2022-3B6/Chirurginoux/3D/STL 2.0/Bras séparé Roulement.STL

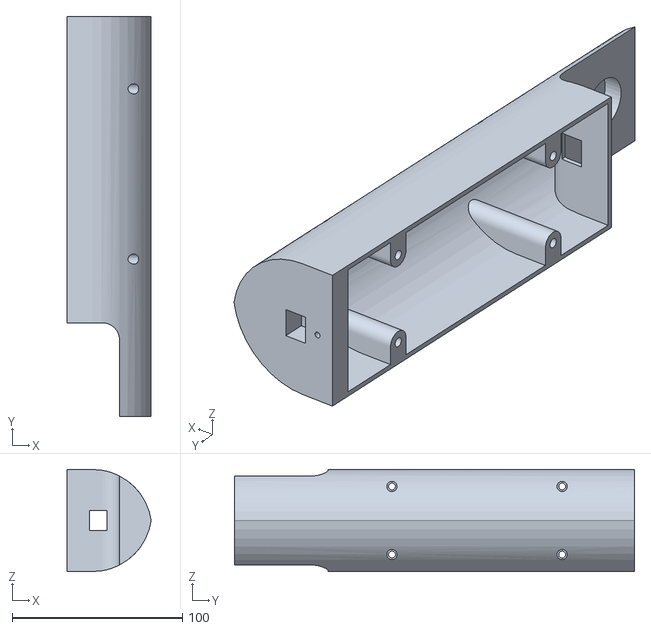
[picture p45: CAD file, 2022-01-20]
3D/STL 2.0/Bras séparé Roulement.STL
49.6 x 235.0 x 60.0
