Projet-Esme-2022-3B6/Chirurginoux/3D/Fichier STL/CCR10SPRO_Support Moteur 2.0.3mf

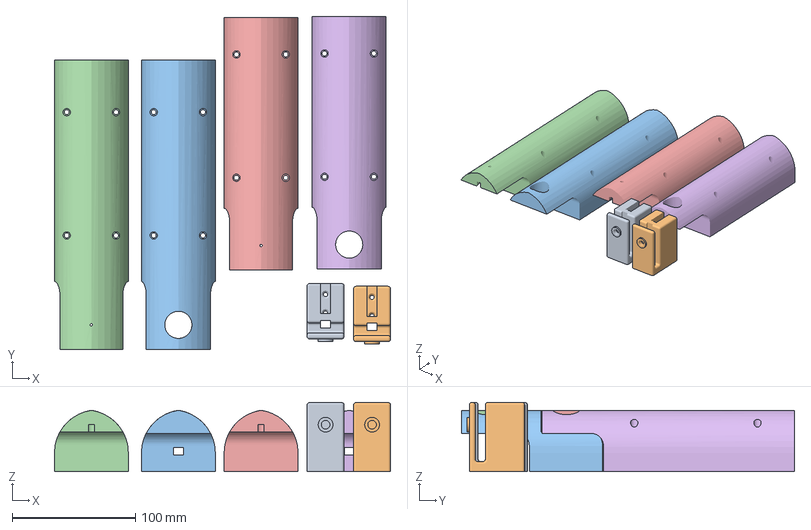
[picture p46: CAD file, 2022-01-17]
3D/Fichier STL/CCR10SPRO_Support Moteur 2.0.3mf
272.7 x 270.1 x 56.0 mm
Support Moteur 2.0.STL
Support Moteur 2.0.STL(1)
Bras séparé en deux1 .STL
Bras séparé en deux2 .STL
Avant Bras séparé en deux2.STL
Avant Bras séparé en deux1.STL
