Projet-Esme-2022-3B6/Chirurginoux/3D/3D 2.0/Motor/Servo MG996R/Servo Control Horns MG996R.SLDPRT

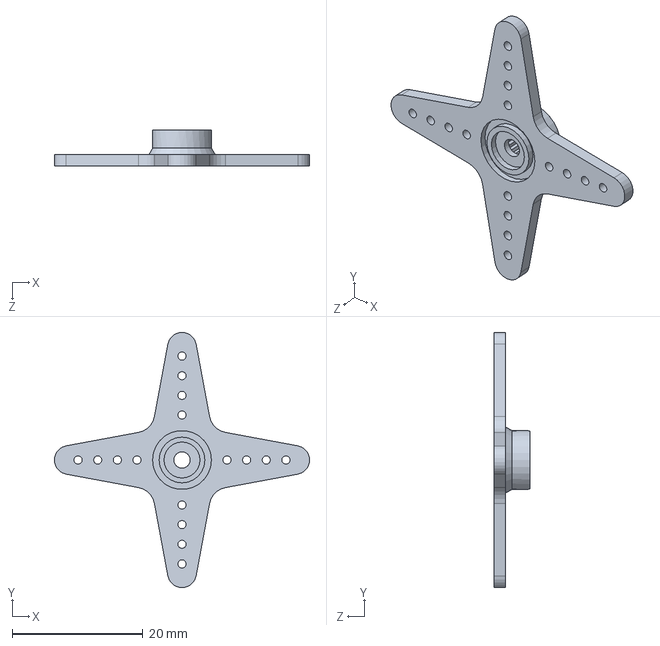
[picture p48: CAD file, 2022-01-17]
3D/3D 2.0/Motor/Servo MG996R/Servo Control Horns MG996R.SLDPRT
39.0 x 39.0 x 5.50 mm
