Projet-Esme-2022-3B6/Chirurginoux/3D/Ancienne Version/3D V3/Support Moteur 2.0.SLDPRT

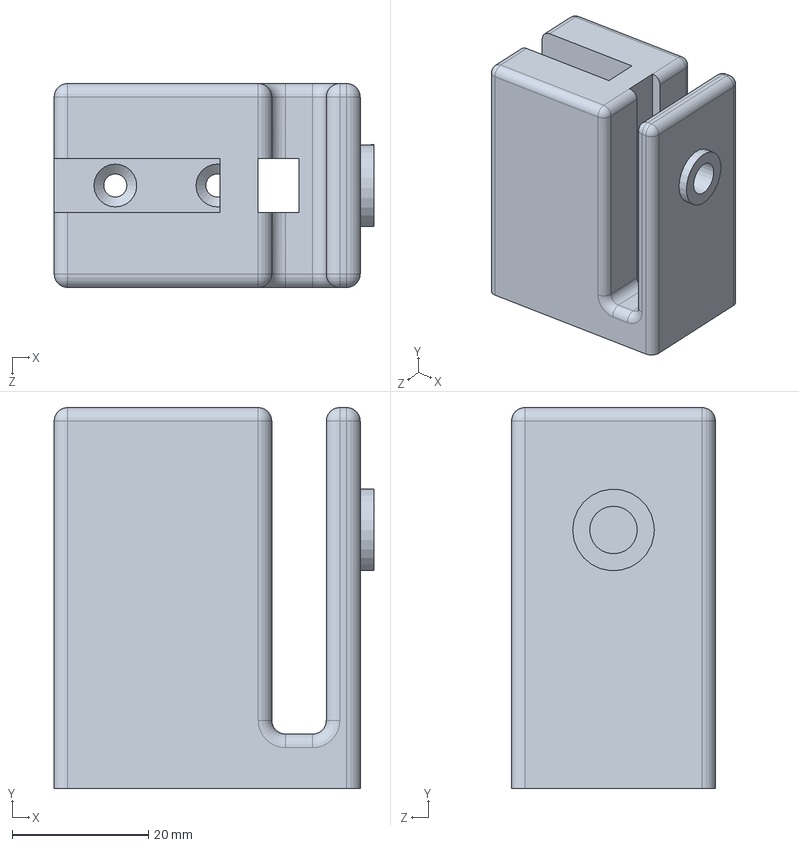
[picture p49: CAD file, 2022-01-17]
3D/Ancienne Version/3D V3/Support Moteur 2.0.SLDPRT
47.0 x 56.0 x 30.0 mm
