Projet-Esme-2022-3B6/Chirurginoux/3D/STL 2.0/Avant Bras séparé Roulement.STL

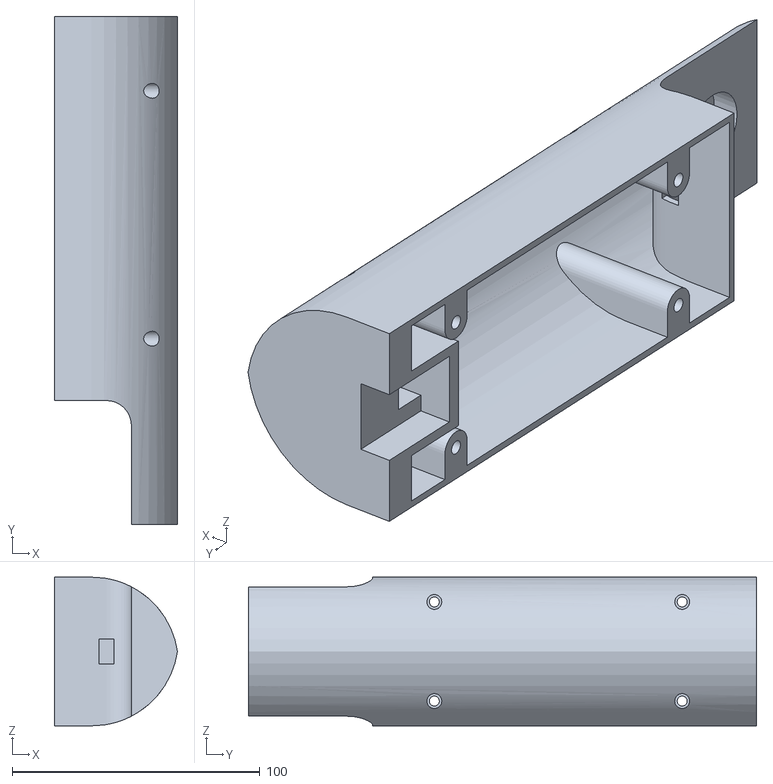
[picture p50: CAD file, 2022-01-20]
3D/STL 2.0/Avant Bras séparé Roulement.STL
49.6 x 205.0 x 60.0
