Projet-Esme-2022-3B6/Chirurginoux/3D/Fichier STL/Support Moteur 2.0.STL

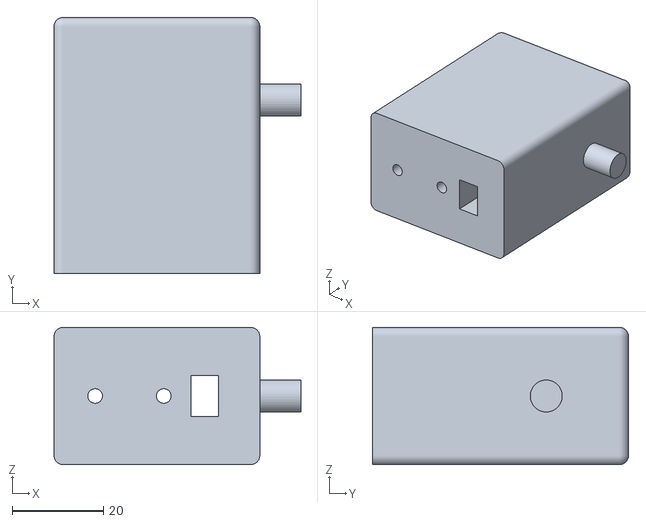
[picture p51: CAD file, 2022-01-17]
3D/Fichier STL/Support Moteur 2.0.STL
54.0 x 56.0 x 30.0
