Projet-Esme-2022-3B6/Chirurginoux/3D/STL 2.0/Bras séparé Motor.STL

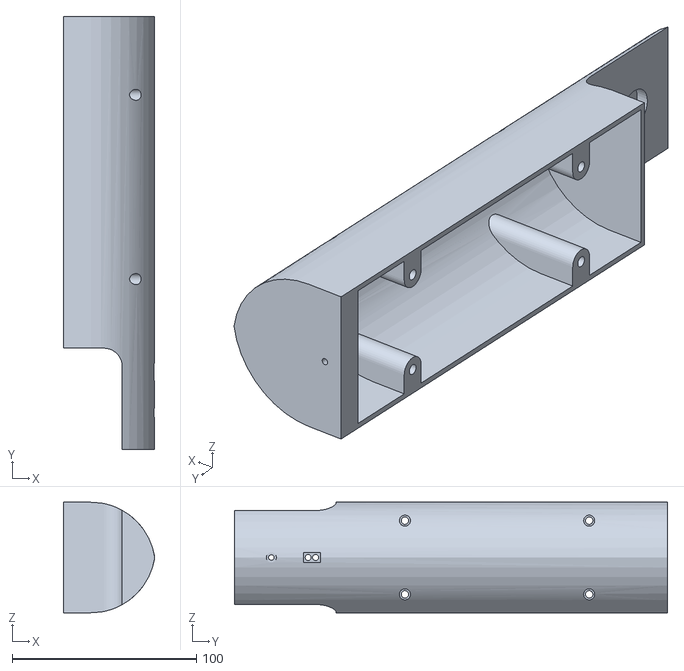
[picture p52: CAD file, 2022-01-20]
3D/STL 2.0/Bras séparé Motor.STL
49.6 x 235.0 x 60.0
