Projet-Esme-2022-3B6/Chirurginoux/3D/Fichier STL/Avant Bras séparé en deux2.STL

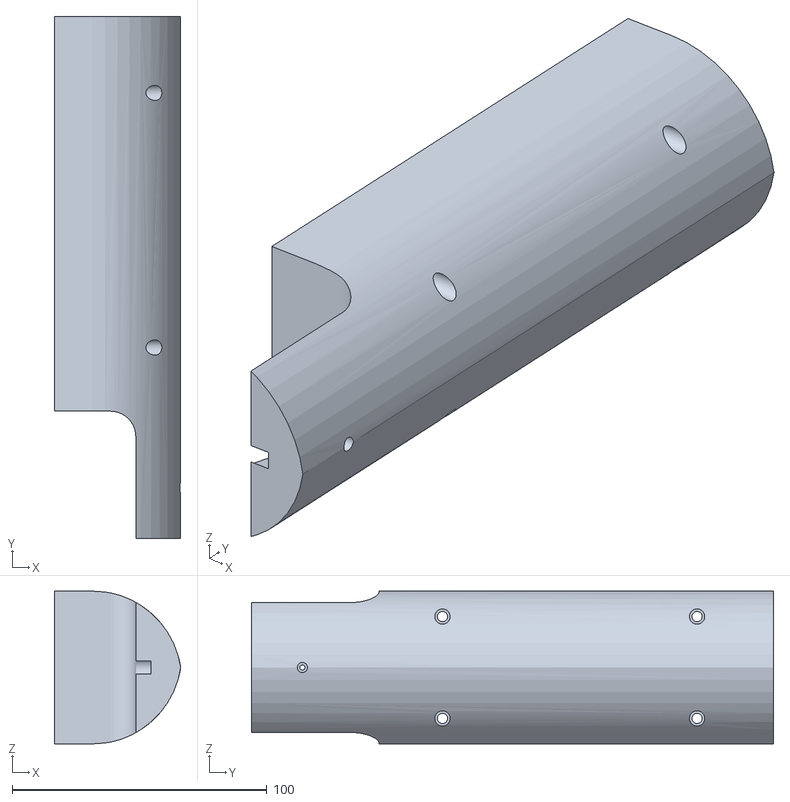
[picture p53: CAD file, 2022-01-17]
3D/Fichier STL/Avant Bras séparé en deux2.STL
49.6 x 205.0 x 60.0
