Projet-Esme-2022-3B6/Chirurginoux/(list of files, cad)

Other CAD files:
3D/3D 2.0/Tronc/Assemblage Pate Tronc.sldasm
3D/3D 2.0/Roulement à billes/Roulement 2.SLDPRT
3D/3D/Avant bras/Avant Bras séparé en deux2.SLDPRT
3D/3D/Roulement à billes/Roulement 1.SLDPRT
3D/Ancienne Version/3D V3/Avant bras/Avant Bras séparé en deux2.SLDPRT
3D/Ancienne Version/3D V3/Bras/Bras séparé en deux2 .SLDPRT
3D/Fichier STL/Bras séparé en deux1 .STL
3D/3D 2.0/Bras/Bras séparé Roulement.SLDPRT
3D/3D 2.0/Motor/Servo MG996R/Bottom MG996R.SLDPRT
3D/3D 2.0/Roulement à billes/Roulement 3.SLDPRT
3D/3D/Avant bras/Avant Bras séparé en deux1.SLDPRT
3D/3D/Bras/Bras séparé en deux2 .SLDPRT
3D/Ancienne Version/3D V3/Avant bras/Avant Bras séparé en deux1.SLDPRT
3D/Ancienne Version/3D V3/Bras/Bras séparé en deux1 .SLDPRT
3D/Ancienne Version/3D V3/Motor/Servo MG996R/Shaft MG996R.SLDPRT
3D/Ancienne Version/3D V3/Roulement à billes/Roulement 3.SLDPRT
3D/STL 2.0/tronc.STL
3D/3D 2.0/Motor/Servo MG996R/Top MG996R.SLDPRT
3D/3D 2.0/Roulement à billes/Roulement 5.SLDPRT
3D/3D 2.0/Support Moteur 2.0.SLDPRT
3D/3D 2.0/Tronc/Pate Tronc.sldprt
3D/3D/Motor/Servo MG996R/Shaft MG996R.SLDPRT
3D/3D/Roulement à billes/Roulement 4.SLDPRT
3D/Ancienne Version/3D V3/Motor/Servo MG996R/Middle MG996R.SLDPRT
3D/Ancienne Version/3D V3/Roulement à billes/Roulement 2.SLDPRT
3D/3D 2.0/base.SLDPRT
3D/3D 2.0/Motor/Servo MG996R/Middle MG996R.SLDPRT
3D/3D 2.0/Roulement à billes/Roulement 1.SLDPRT
3D/3D/base.SLDPRT
3D/3D/Motor/Servo MG996R/Bottom MG996R.SLDPRT
3D/3D/Roulement à billes/Roulement 3.SLDPRT
3D/Ancienne Version/3D V3/Motor/Servo 35KG/CONNECTOR.SLDPRT
3D/Ancienne Version/3D V3/Motor/Servo MG996R/Connector MG996R.SLDPRT
3D/Ancienne Version/3D V3/Roulement à billes/Roulement 5.SLDPRT
3D/3D 2.0/Motor/Servo 35KG/CONNECTOR.SLDPRT
3D/3D/Roulement à billes/Roulement 5.SLDPRT
3D/3D/tronc.SLDPRT
3D/Ancienne Version/3D V3/Motor/Servo 35KG/SHAFT.SLDPRT
3D/Ancienne Version/3D V3/Motor/Servo MG996R/Bottom MG996R.SLDPRT
3D/Ancienne Version/3D V3/Roulement à billes/Roulement 1.SLDPRT
3D/Fichier STL/Bras séparé en deux2 .STL
3D/3D 2.0/Motor/Servo 35KG/Horns 25T.SLDPRT
3D/3D 2.0/Motor/Servo MG996R/Shaft MG996R.SLDPRT
3D/3D 2.0/Roulement à billes/Roulement 4.SLDPRT
3D/3D/Motor/Servo 35KG/BODY, MIDDLE.SLDPRT
3D/3D/Motor/Servo MG996R/Middle MG996R.SLDPRT
3D/3D/Roulement à billes/Roulement 2.SLDPRT
3D/Ancienne Version/3D V3/Motor/Servo 35KG/BOTTOM.SLDPRT
3D/Ancienne Version/3D V3/Motor/Servo MG996R/Top MG996R.SLDPRT
3D/Ancienne Version/3D V3/Roulement à billes/Roulement 4.SLDPRT
3D/3D 2.0/Motor/Servo 35KG/BODY, MIDDLE.SLDPRT
3D/3D/Motor/Servo 35KG/CONNECTOR.SLDPRT
3D/3D/Motor/Servo MG996R/Top MG996R.SLDPRT
3D/Ancienne Version/3D V3/Motor/Servo MG996R/Servo Control Horns MG996R.SLDPRT
3D/Fichier STL/tronc.STL
3D/Ancienne Version/3D V3/Motor/Servo 35KG/BODY, TOP.SLDPRT
3D/Fichier STL/base.STL
3D/3D 2.0/Pièce_support_scalpel.STL
3D/Ancienne Version/3D V0.4/Assemblage Base-Tronc-bras-avantbras.SLDASM
3D/Ancienne Version/3D V0.4/Avant bras/Avant bras séparé en deux1 .SLDPRT
3D/Ancienne Version/3D V0.4/Avant bras/Avant bras séparé en deux2 .SLDPRT
3D/Ancienne Version/3D V0.4/Bras/Bras séparé en deux1 .SLDPRT
3D/Ancienne Version/3D V0.4/Bras/Bras séparé en deux2 .SLDPRT
3D/Ancienne Version/3D V0.4/Roulement à billes/Assemblage Roulement.SLDASM
3D/Ancienne Version/3D V0.4/Roulement à billes/Roulement 1.SLDPRT
3D/Ancienne Version/3D V0.4/Roulement à billes/Roulement 2.SLDPRT
3D/Ancienne Version/3D V0.4/Roulement à billes/Roulement 3.SLDPRT
3D/Ancienne Version/3D V0.4/Roulement à billes/Roulement 4.SLDPRT
3D/Ancienne Version/3D V0.4/Roulement à billes/Roulement 5.SLDPRT
3D/Ancienne Version/3D V0.4/Support Moteur 2.0.SLDPRT
3D/Ancienne Version/3D V0.4/Test/Bras 1.SLDPRT
3D/Ancienne Version/3D V0.4/Test/Bras 2.SLDPRT
3D/Ancienne Version/3D V0.4/Test/Support Moteur.SLDPRT
3D/Ancienne Version/3D V0.4/base - Copie.SLDPRT
3D/Ancienne Version/3D V0.4/tronc.SLDPRT
3D/Ancienne Version/3D V1/Assemblage Base-Tronc.SLDASM
3D/Ancienne Version/3D V1/Avant bras/Avant bras séparé en deux1 .SLDPRT
3D/Ancienne Version/3D V1/Avant bras/Avant bras séparé en deux2 .SLDPRT
3D/Ancienne Version/3D V1/Bras/Bras séparé en deux1 .SLDPRT
3D/Ancienne Version/3D V1/Bras/Bras séparé en deux2 .SLDPRT
3D/Ancienne Version/3D V1/Motor/Servo 35KG/BODY, TOP.SLDPRT
3D/Ancienne Version/3D V1/Motor/Servo 35KG/BOTTOM.SLDPRT
3D/Ancienne Version/3D V1/Motor/Servo 35KG/CONNECTOR.SLDPRT
3D/Ancienne Version/3D V1/Motor/Servo 35KG/SHAFT.SLDPRT
3D/Ancienne Version/3D V1/Motor/Servo MG996R/Bottom MG996R.SLDPRT
3D/Ancienne Version/3D V1/Motor/Servo MG996R/Connector MG996R.SLDPRT
3D/Ancienne Version/3D V1/Motor/Servo MG996R/Middle MG996R.SLDPRT
3D/Ancienne Version/3D V1/Motor/Servo MG996R/Servo Control Horns MG996R.SLDPRT
3D/Ancienne Version/3D V1/Motor/Servo MG996R/Shaft MG996R.SLDPRT
3D/Ancienne Version/3D V1/Motor/Servo MG996R/Top MG996R.SLDPRT
3D/Ancienne Version/3D V1/Roulement à billes/Roulement 1.SLDPRT
3D/Ancienne Version/3D V1/Roulement à billes/Roulement 2.SLDPRT
3D/Ancienne Version/3D V1/Roulement à billes/Roulement 3.SLDPRT
3D/Ancienne Version/3D V1/Roulement à billes/Roulement 4.SLDPRT
3D/Ancienne Version/3D V1/Roulement à billes/Roulement 5.SLDPRT
3D/Ancienne Version/3D V1/Support Moteur 2.0.SLDPRT
3D/Ancienne Version/3D V1/tronc.SLDPRT
3D/Ancienne Version/3D V2/Assemblage Base-Tronc.SLDASM
3D/Ancienne Version/3D V2/Avant bras/Avant_Bras séparé en deux1.SLDPRT
3D/Ancienne Version/3D V2/Avant bras/Avant_Bras séparé en deux2.SLDPRT
3D/Ancienne Version/3D V2/Bras/Bras séparé en deux1 .SLDPRT
3D/Ancienne Version/3D V2/Bras/Bras séparé en deux2 .SLDPRT
3D/Ancienne Version/3D V2/Motor/Servo 35KG/BODY, TOP.SLDPRT
3D/Ancienne Version/3D V2/Motor/Servo 35KG/BOTTOM.SLDPRT
3D/Ancienne Version/3D V2/Motor/Servo 35KG/CONNECTOR.SLDPRT
3D/Ancienne Version/3D V2/Motor/Servo 35KG/SHAFT.SLDPRT
3D/Ancienne Version/3D V2/Motor/Servo MG996R/Bottom MG996R.SLDPRT
3D/Ancienne Version/3D V2/Motor/Servo MG996R/Connector MG996R.SLDPRT
3D/Ancienne Version/3D V2/Motor/Servo MG996R/Middle MG996R.SLDPRT
3D/Ancienne Version/3D V2/Motor/Servo MG996R/Servo Control Horns MG996R.SLDPRT
3D/Ancienne Version/3D V2/Motor/Servo MG996R/Shaft MG996R.SLDPRT
3D/Ancienne Version/3D V2/Motor/Servo MG996R/Top MG996R.SLDPRT
3D/Ancienne Version/3D V2/Roulement à billes/Roulement 1.SLDPRT
3D/Ancienne Version/3D V2/Roulement à billes/Roulement 2.SLDPRT
3D/Ancienne Version/3D V2/Roulement à billes/Roulement 3.SLDPRT
3D/Ancienne Version/3D V2/Roulement à billes/Roulement 4.SLDPRT
3D/Ancienne Version/3D V2/Roulement à billes/Roulement 5.SLDPRT
3D/Ancienne Version/3D V2/Support Moteur 2.0.SLDPRT
3D/Ancienne Version/3D V2/tronc.SLDPRT
3D/Archives/3D/Avant bras/Avant Bras séparé en deux1.SLDPRT
3D/Archives/3D/Avant bras/Avant Bras séparé en deux2.SLDPRT
3D/Archives/3D/Bras/Bras séparé en deux2 .SLDPRT
3D/Archives/3D/Motor/Servo 35KG/BODY, MIDDLE.SLDPRT
3D/Archives/3D/Motor/Servo 35KG/CONNECTOR.SLDPRT
3D/Archives/3D/Motor/Servo 35KG/Servo Control Horns.SLDPRT
3D/Archives/3D/Motor/Servo MG996R/Bottom MG996R.SLDPRT
3D/Archives/3D/Motor/Servo MG996R/Middle MG996R.SLDPRT
3D/Archives/3D/Motor/Servo MG996R/Shaft MG996R.SLDPRT
3D/Archives/3D/Motor/Servo MG996R/Top MG996R.SLDPRT
3D/Archives/3D/Roulement à billes/Roulement 1.SLDPRT
3D/Archives/3D/Roulement à billes/Roulement 2.SLDPRT
3D/Archives/3D/Roulement à billes/Roulement 3.SLDPRT
3D/Archives/3D/Roulement à billes/Roulement 4.SLDPRT
3D/Archives/3D/Roulement à billes/Roulement 5.SLDPRT
3D/Archives/3D/base.SLDPRT
3D/Archives/3D/tronc.SLDPRT
3D/STL 2.0/base.STL
