Projet-Esme-2022-3B6/Chirurginoux/(commit log)

2022-01-17 init of repo
    [Assemblage Base-Tronc-bras-avantbras.SLDASM, Assemblage Base-Tronc.SLDASM, Assemblage Kinect Arm 2.0.SLDASM, Assemblage Pate Tronc.sldasm, Assemblage Roulement.SLDASM, Avant Bras séparé en deux1.SLDPRT, Avant Bras séparé en deux1.STL, Avant Bras séparé en deux2.SLDPRT]
2022-01-18 hand change
    [Assemblage Kinect Arm 2.0.SLDASM, Bras séparé en deux1 .SLDPRT, Bras séparé en deux2 .SLDPRT]
2022-01-20 STL remake
    [Avant Bras séparé Motor.STL, Avant Bras séparé Roulement.STL, Bras séparé Motor.STL, Bras séparé Roulement.STL, Pate Tronc.STL, base.STL, tronc.STL]
2022-03-24 modèle géo de Ugo sur python
